darktheDE/project25_IOT04_Group19/pics/Nhom25_SoDoMach.jpg

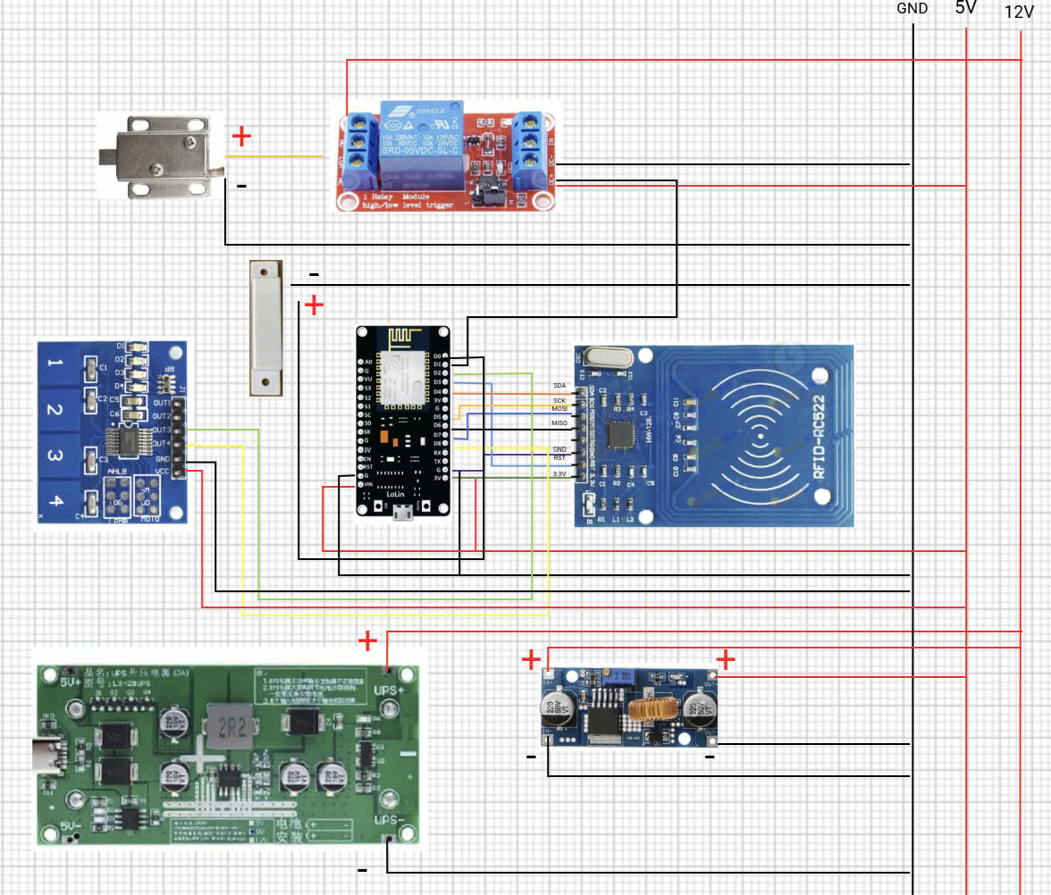
pics/Nhom25_SoDoMach.jpg
