darktheDE/project25_IOT04_Group19/19_IoT04_IoT/TaiLieuThamKhao/HinhAnhDoAn/z6535141486462_78d6391947289e566dee0246125c6988.jpg

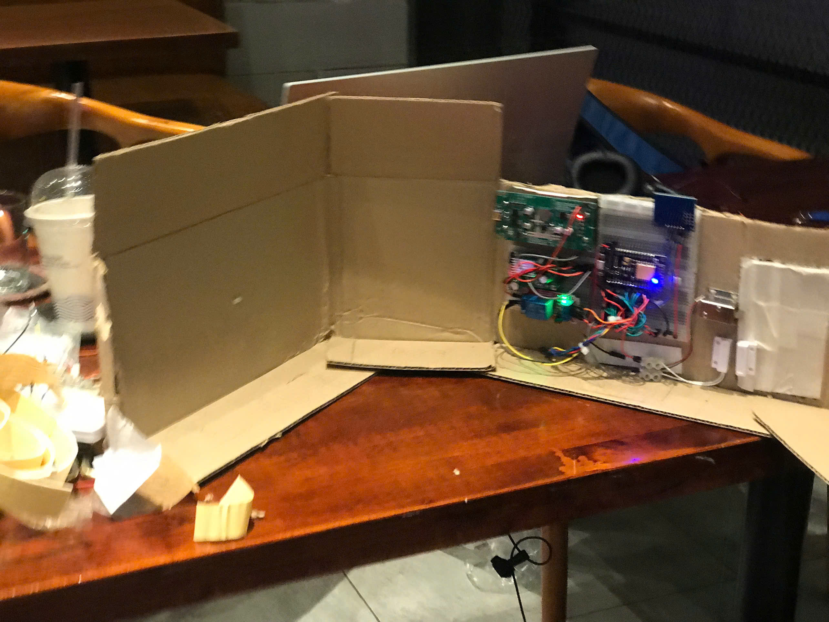
19_IoT04_IoT/TaiLieuThamKhao/HinhAnhDoAn/z6535141486462_78d6391947289e566dee0246125c6988.jpg
