darktheDE/project25_IOT04_Group19/pics/pinout.pdf

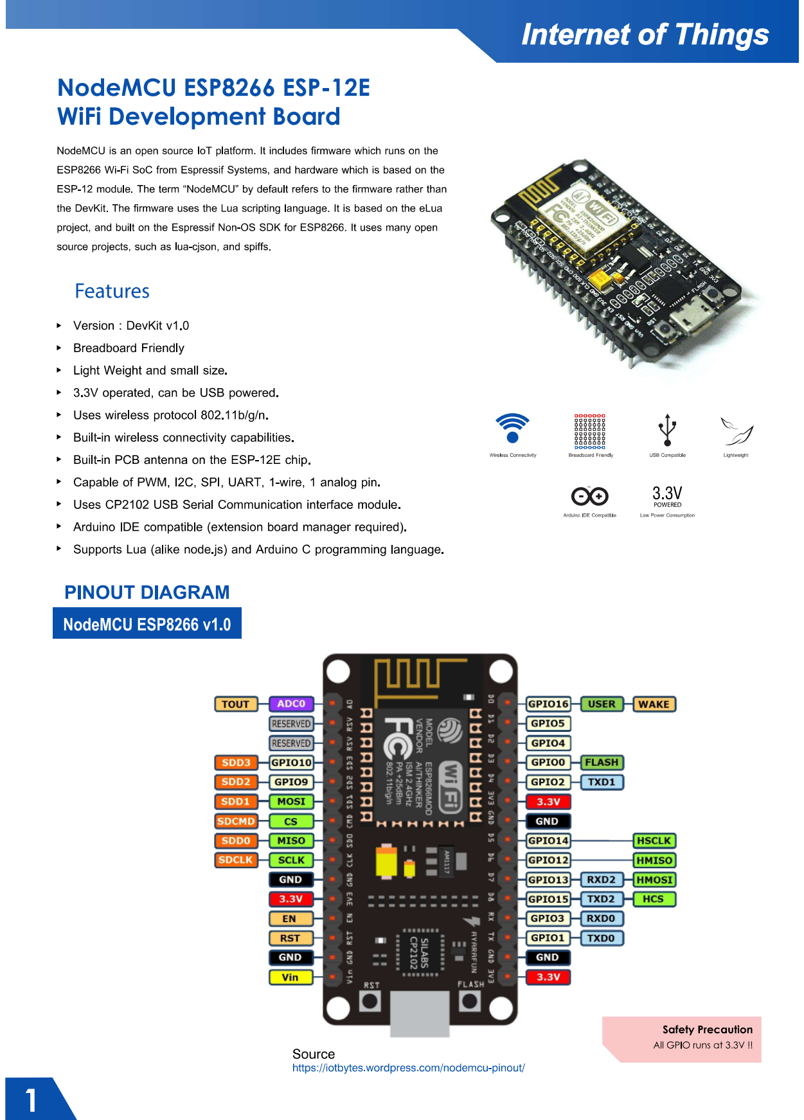
[picture p11: page 1]
