darktheDE/project25_IOT04_Group19/pics/Specifications.pdf

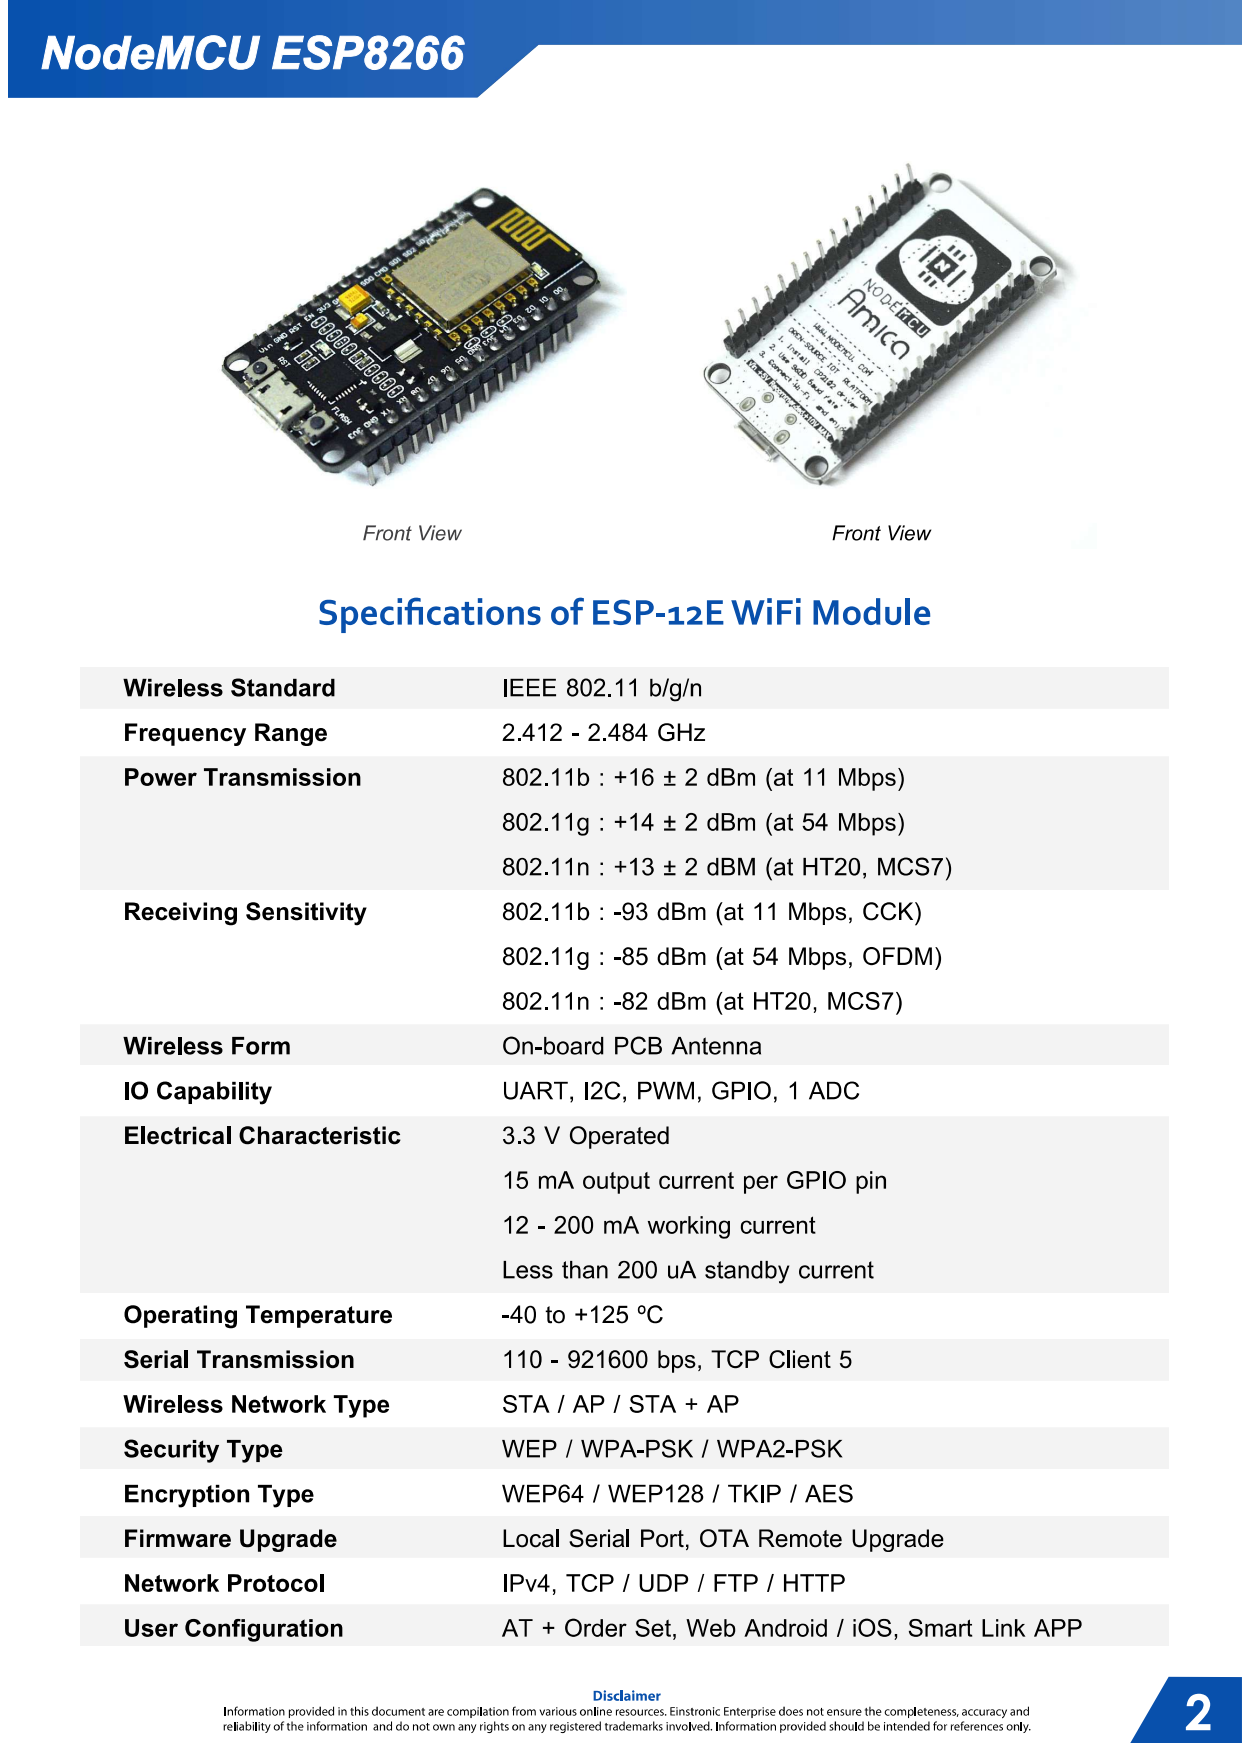
[picture p12: page 1]
