darktheDE/project25_IOT04_Group19/19_IoT04_IoT/TaiLieuThamKhao/HinhAnhDoAn/z6535141482431_e22bba6d9e96984849c6a3ddab4554ef.jpg

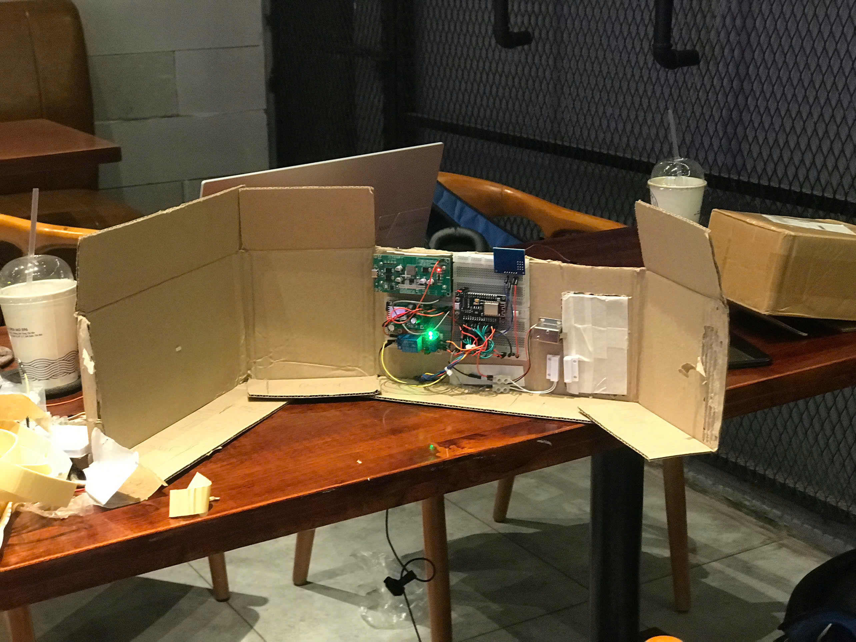
19_IoT04_IoT/TaiLieuThamKhao/HinhAnhDoAn/z6535141482431_e22bba6d9e96984849c6a3ddab4554ef.jpg
