darktheDE/project25_IOT04_Group19/19_IoT04_IoT/TaiLieuThamKhao/HinhAnhDoAn/z6535141493313_4c0f7d2451fd1ea9bee3035136d27214.jpg

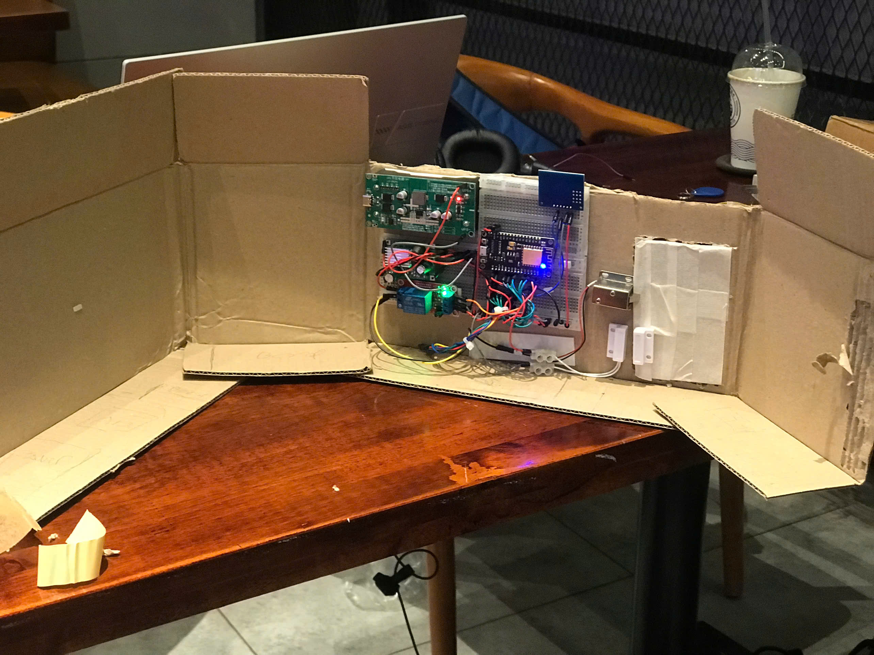
19_IoT04_IoT/TaiLieuThamKhao/HinhAnhDoAn/z6535141493313_4c0f7d2451fd1ea9bee3035136d27214.jpg
