darktheDE/project25_IOT04_Group19/19_IoT04_IoT/TaiLieuThamKhao/HinhAnhDoAn/z6535141580571_3ca2618eaea1aace6fb657504517bff3.jpg

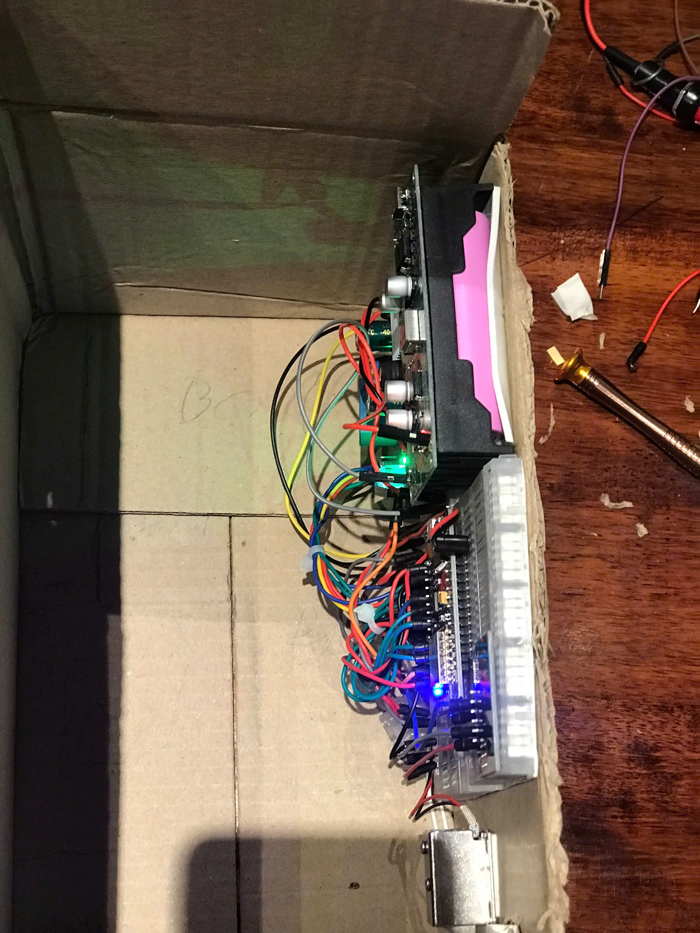
19_IoT04_IoT/TaiLieuThamKhao/HinhAnhDoAn/z6535141580571_3ca2618eaea1aace6fb657504517bff3.jpg
