darktheDE/project25_IOT04_Group19/19_IoT04_IoT/TaiLieuThamKhao/HinhAnhDoAn/z6535141704568_0392a0b8e210030055046f2013834f25.jpg

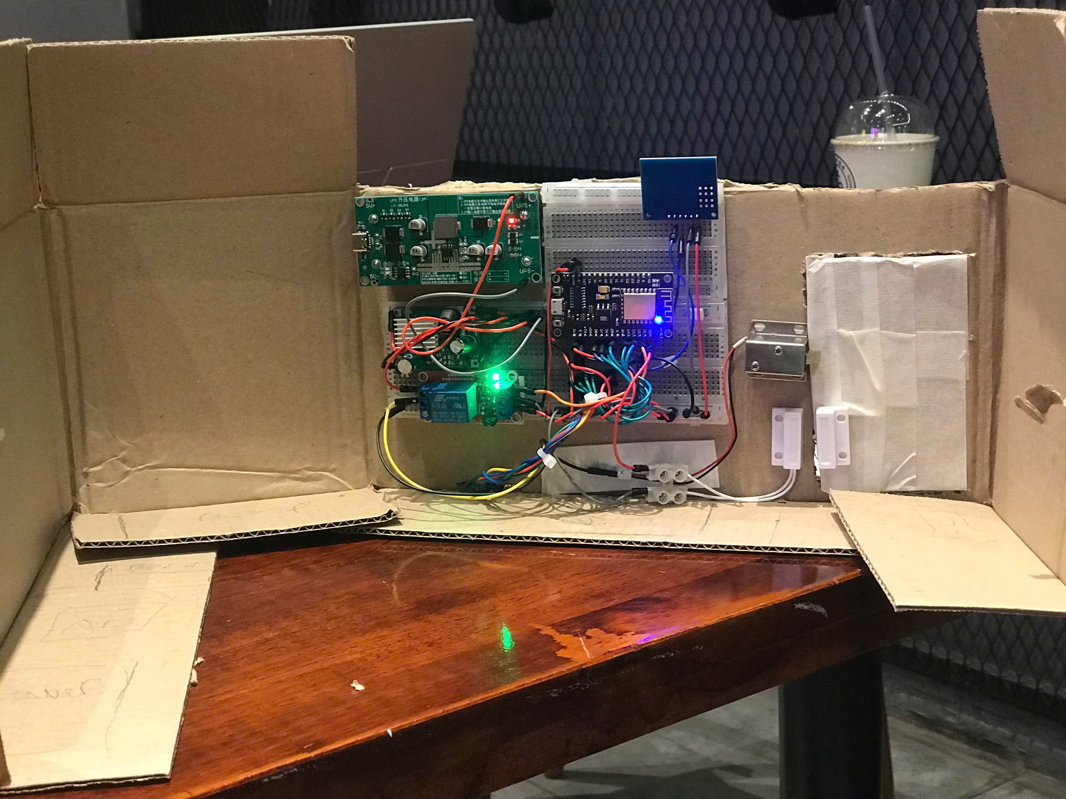
19_IoT04_IoT/TaiLieuThamKhao/HinhAnhDoAn/z6535141704568_0392a0b8e210030055046f2013834f25.jpg
