darktheDE/project25_IOT04_Group19/19_IoT04_IoT/TaiLieuThamKhao/HinhAnhDoAn/z6535141791472_cf770976732cb89a7050112cc91fb10f.jpg

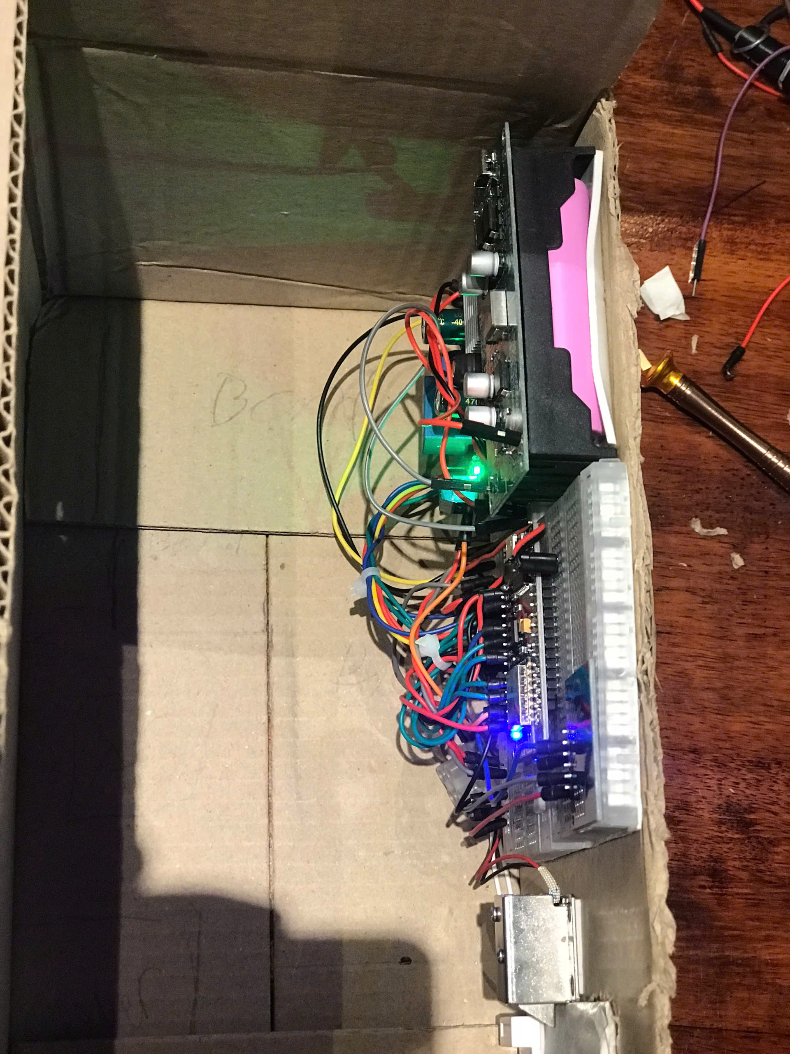
19_IoT04_IoT/TaiLieuThamKhao/HinhAnhDoAn/z6535141791472_cf770976732cb89a7050112cc91fb10f.jpg
