darktheDE/project25_IOT04_Group19/19_IoT04_IoT/TaiLieuThamKhao/flowchart/setup.drawio.png

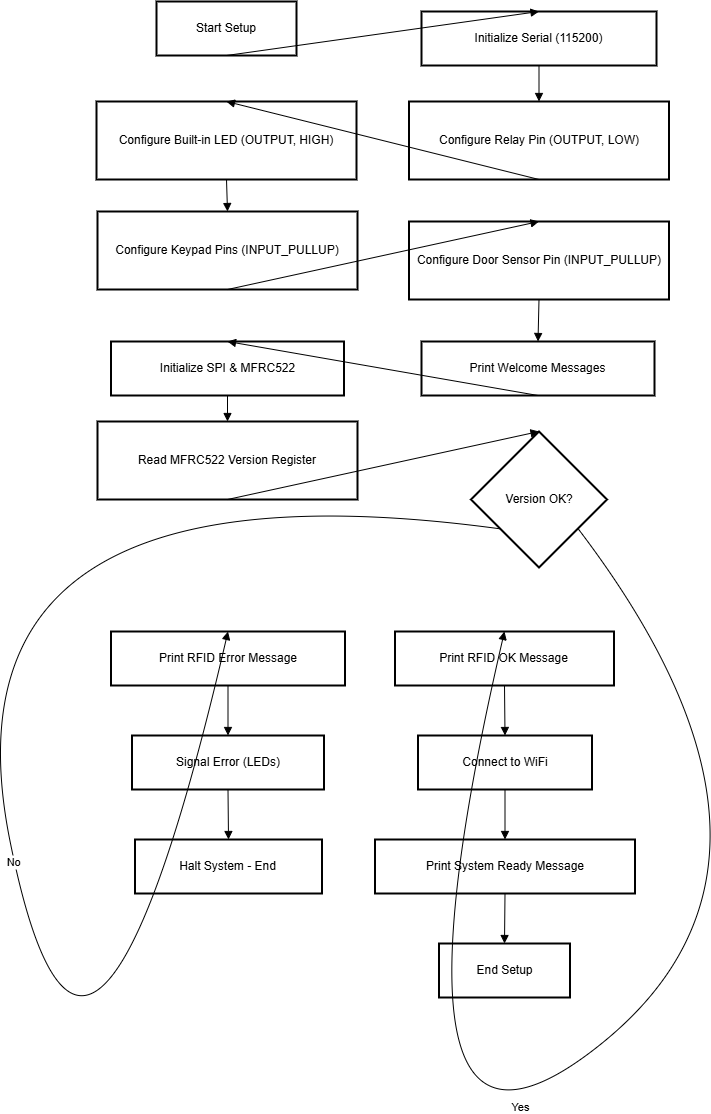
19_IoT04_IoT/TaiLieuThamKhao/flowchart/setup.drawio.png
